langjk/ProjectForCurrentSource/电路功能需求(1)(4)re.docx

电路功能概述

5V模块焊盘

输出正负极

5V删掉

保护电路

顺序下周

上电重启

地址问题

本设计为电流输出模块，提供4路独立的电流输出。

系统通过蓝牙或Wi-Fi 2.4GHz进行通讯控制控制，-倾向用哪种，通讯协议如何 （倾向于蓝牙通讯，需要通讯延迟低。低功耗蓝BLE？）

确保实时精准调节电流强弱，通电持续时间等。

通电持续时间是一个可设置值吗？几百毫秒级的持续时间误差是否可以接受？re：是可设置值，几百毫秒可以接受的，尽量低些。

电源输入采用Type-C接口，满足便携式、低功耗应用需求。-多少mAh电池用多少天。(是否根据功耗来计算？使用场景：每次输出时长10-30分钟，一周内预计用5-6次，考虑电路功耗，一周一充，电池应该＞300 mAh？)

长期待机，还是可以用按键开机？ re：可以按键开机。

关键技术参数和性能指标

- 电流输出：4路独立可调（PMW?），每路 0-4mA，调节精度 ±0.5%，动态显示当前电流值 -显示屏什么要求（正常手机屏幕显示大小，可否连接安卓或苹果手机平台）显示是否可以用数码管/点阵液晶显示re：连接手机显示是否困难？快速出个产品的话可以用数码管/点阵液晶显示，除了电流值还有其他显示内容吗？re：其他信息能显示都显示，便于调试优化；电流显示小数点后边几位？误差：4*±0.5%=0.02，如显示小数点后边2位，会给客户很差体验，是否只显示一位小数？re: 可以一位小数
- 通信接口：蓝牙或 Wi-Fi 2.4GHz通讯，远程控制，调节延迟 ≤5ms。 蓝牙
- 电源输入：Type-C接口供电，适用于便携式应用。
- 尺寸：＜长5*宽5*高2cm 越小越好
- 自动安全保护：电流过载监测、短路保护、自动断电功能，确保刺激安全-什么地方会出现过载，过载范围多大，什么情况自动断电（导线短路：当电流检测回路监测到输出电流远超设定值（如 >4 mA +保护阈值）时，判定为过载。可设置一个略大于预设电流的硬件监测阈值（例如 预设电流2 mA, 阈值为2.2 mA、2.5 mA）

断电：器件温度超标时，超过设定过载阈值并维持超过预设时间窗口时断电
