langjk/ProjectForCurrentSource/盖.SLDPRT

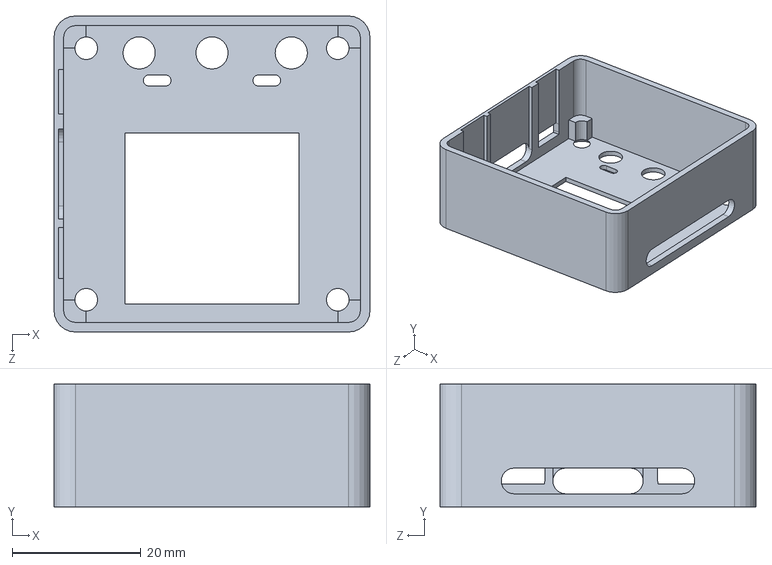
[picture p17: CAD file, 2025-12-16]
盖.SLDPRT
49.0 x 19.0 x 49.0 mm
