langjk/ProjectForCurrentSource/底.SLDPRT

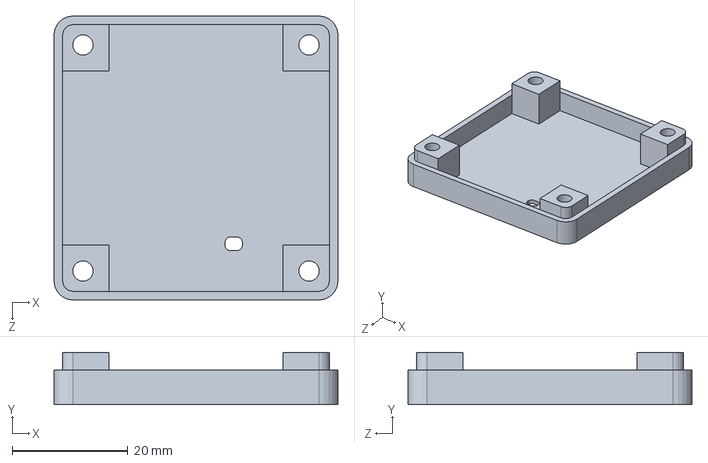
[picture p18: CAD file, 2025-12-16]
底.SLDPRT
49.0 x 9.00 x 49.0 mm
