langjk/ProjectForCurrentSource/(list of files, cad)

Other CAD files:
底.STL
盖.STL
