langjk/ProjectForCurrentSource/ProjectForCurrentSource.ioc

Mcu.UserName=STM32F103C8Tx
PA1.Signal=S_TIM2_CH2
PA10.Signal=USART1_RX
PA13.Signal=SYS_JTMS-SWDIO
PA14.Signal=SYS_JTCK-SWCLK
PA3.GPIO_Label=KEY1
PA3.Signal=GPIO_Input
PA4.GPIO_Label=KEY2
PA4.Signal=GPIO_Input
PA5.GPIO_Label=KEY3
PA5.Signal=GPIO_Input
PA6.Signal=S_TIM3_CH1
PA8.Signal=S_TIM1_CH1
PA9.Signal=USART1_TX
PB6.Signal=S_TIM4_CH1
PB8.Signal=I2C1_SCL
PB9.Signal=I2C1_SDA
PD0-OSC_IN.Signal=RCC_OSC_IN
PD1-OSC_OUT.Signal=RCC_OSC_OUT
