langjk/ProjectForCurrentSource/Core/Inc/main.h

#define KEY1_Pin GPIO_PIN_3
#define KEY1_GPIO_Port GPIOA
#define KEY2_Pin GPIO_PIN_4
#define KEY2_GPIO_Port GPIOA
#define KEY3_Pin GPIO_PIN_5
#define KEY3_GPIO_Port GPIOA
