langjk/ProjectForCurrentSource/(commit log)

2025-12-16 四路电流源
    [底.SLDPRT, 底.STL, 盖.SLDPRT, 盖.STL]
2026-04-27 Refine calibration flow and output handling
